swthemathwiz/hp-z6-g4-memory-fan-mounts/hp-z6-memory-fan-mount-dual-80-80.scad

//
// Copyright (c) Stewart H. Whitman, 2024.
//
// File:    hp-z6-memory-fan-mount-dual-80-80.scad
// Project: HP Z6 G4 Memory Fan Mounts
// License: CC BY-NC-SA 4.0 (Attribution-NonCommercial-ShareAlike)
// Desc:    Dual memory fan mount build (80 mm secondary)
//

include <hp-z6-memory-fan-mounts.scad>
model = "dual";
