swthemathwiz/hp-z6-g4-memory-fan-mounts/smidge.scad

//
// Copyright (c) Stewart H. Whitman, 2021-2024.
//
// File:    smidge.scad
// Project: General
// License: CC BY-NC-SA 4.0 (Attribution-NonCommercial-ShareAlike)
// Desc:    SMIDGE constant used in preview mode.
//

// Smidge constant for rendering only (to avoid Z-axis fighting, etc.)
SMIDGE = 0.01;
