swthemathwiz/hp-z6-g4-memory-fan-mounts/(list of files, cad)

Other CAD files:
hp-z6-memory-fan-mount-dual-80-80x20.scad
hp-z6-memory-fan-mount-dual-80-80x25.scad
hp-z6-memory-fan-mount-grommits.scad
hp-z6-memory-fan-mount-single-80.scad
hp-z6-memory-fan-mount-washers.scad
