swthemathwiz/hp-z6-g4-memory-fan-mounts/(commit log)

2024-04-27 Add convexity parameter.
    [bridge.scad]
2024-04-27 Make base narrower, wider cuases install problems.
    [hp-z6-catch-bottom.scad]
2024-04-27 Increase layout height
    [hp-z6-catch-top.scad]
2024-04-27 Generally decrease thickness, increase cutout, add retaining holes, increase height of tabs, raise secondary fan
    [hp-z6-memory-fan-mounts.scad]
2024-05-04 Rename model width setting, clean-up some comments, set DIMM spacing
    [hp-z6-memory-fan-mounts.scad]
2024-05-07 Adjust stopper.
    [hp-z6-catch-top.scad]
2024-05-09 Add another fan
2024-05-09 Remove mitered, replace with slanted
    [hp-z6-catch-bottom.scad, hp-z6-catch-top.scad, mitered.scad, slanted.scad]
2024-05-09 Slanted top of fan cage. Transition from mitered to slanted. Misc clean-up.
    [hp-z6-memory-fan-mounts.scad]
2024-05-09 Clean up
    [hp-z6-memory-fan-mounts.scad]
2024-05-09 Clean up whitespace
    [slanted.scad]
2024-05-09 Add gussets to oversize platform
    [hp-z6-memory-fan-mounts.scad]
2024-05-09 Oversize platform gusset cleanup
    [hp-z6-memory-fan-mounts.scad]
2024-05-10 Fix comments
    [hp-z6-catch-top.scad]
2024-05-10 Drop baffle_fan_spacing_radius to 0.2. Move thumbnail to module. Rename top_loader to is_top_loader.
    [hp-z6-memory-fan-mounts.scad]
2024-05-10 Clean-up platform code. Change retainer offset for top loaders
    [hp-z6-memory-fan-mounts.scad]
2024-05-17 Update cable information
2024-05-18 Fix lm-sensors info
2024-05-18 Update lm-sensor info
2024-05-19 Use volume in demo code
    [fan.scad]
2024-05-20 Refactor and add ray/circular for grill
    [line.scad]
2024-05-20 Refactor line to line.scad
    [bridge.scad]
2024-05-20 Add side to hole center primitives
    [fan.scad]
2024-05-20 Add grommits build
    [hp-z6-memory-fan-mount-grommits.scad]
2024-05-20 Initial addition of grill and grommits
    [hp-z6-memory-fan-mounts.scad]
2024-05-20 Add grill normalize setting. Clean up grill
    [hp-z6-memory-fan-mounts.scad]
2024-05-20 Cleanup grill terminology
    [hp-z6-memory-fan-mounts.scad]
2024-05-22 Refactor polar coordinates
    [line.scad, polar.scad]
2024-05-22 Offset grill start. Add rotational replication module. Rename grommits to washers. Rename sec_retainer to security_retainer. Separate washer parameters.
    [hp-z6-memory-fan-mounts.scad]
2024-05-22 Move cable testing to cable section. Add countersunk washers.
2024-05-23 White space cleanup
    [polar.scad]
2024-05-23 Invert thumbnail/sec. cutouts for easier printing. Decrease secondary fan baffle size by adding top/side cutouts and limiting depth.
    [hp-z6-memory-fan-mounts.scad]
2024-05-23 Restore baffle fan spacing to 0.4 mm
    [hp-z6-memory-fan-mounts.scad]
2024-05-28 Raise bridge height. Add a little extra on secondary rear. Decrease bottom of interior slope by half.
    [hp-z6-memory-fan-mount-dual-80-92.scad, hp-z6-memory-fan-mounts.scad]
2024-05-28 White space cleanup.
    [hp-z6-memory-fan-mounts.scad]
2024-05-31 Add 80x80x20 and 80x80x15 fans to available fan specs.
    [fan.scad, hp-z6-memory-fan-mounts.scad]
2024-06-01 Separate grill thickness variable
    [hp-z6-memory-fan-mounts.scad]
2024-06-07 Initial 80x20 fan addition.
    [hp-z6-memory-fan-mount-dual-80-80x20.scad, hp-z6-memory-fan-mount-dual-80-80x25.scad]
2024-06-07 Switch to dual images in instructions
2024-06-12 Add 20mm info
